universalgeek56/UG56-Lab-PSU/images/3D_PCB1_2026-02-25.png

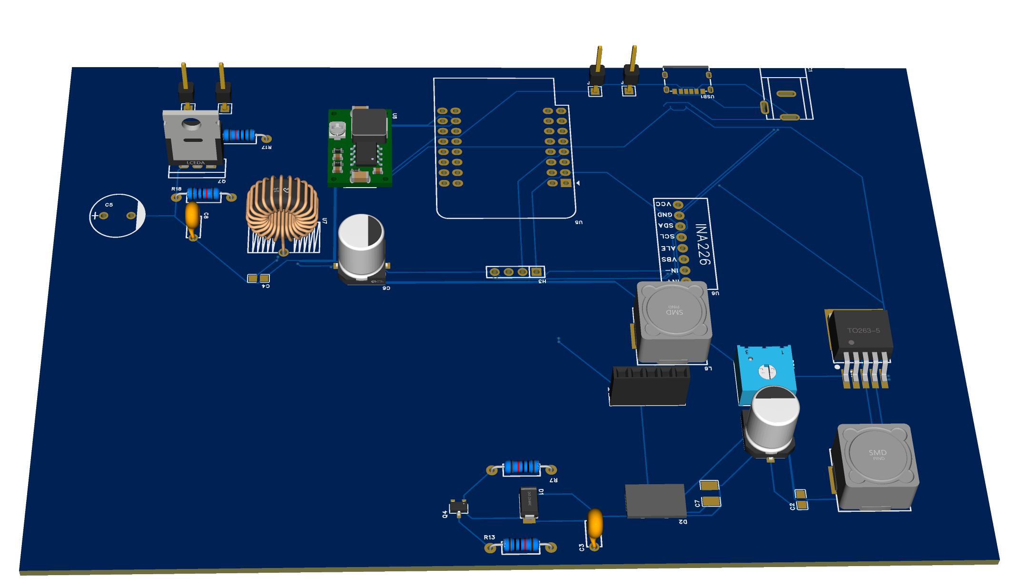
images/3D_PCB1_2026-02-25.png
