universalgeek56/UG56-Lab-PSU/images/AO3400_SMDtoDIP.JPG

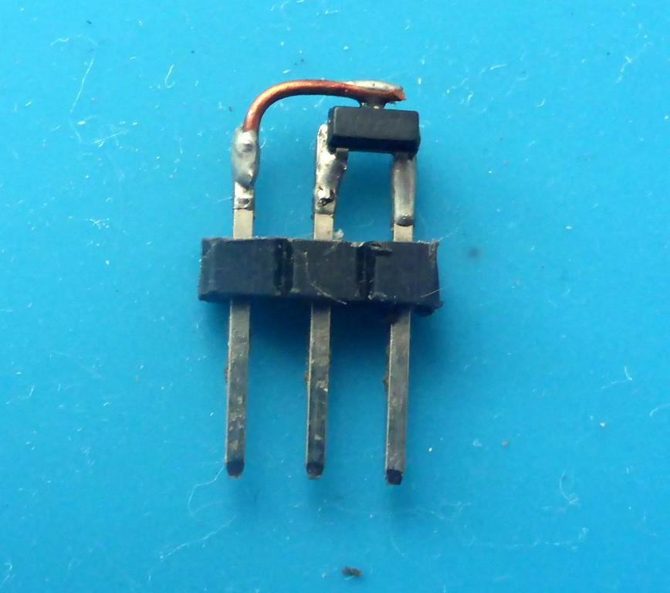
images/AO3400_SMDtoDIP.JPG
