universalgeek56/UG56-Lab-PSU/images/Case_Proto_V1_0.JPG

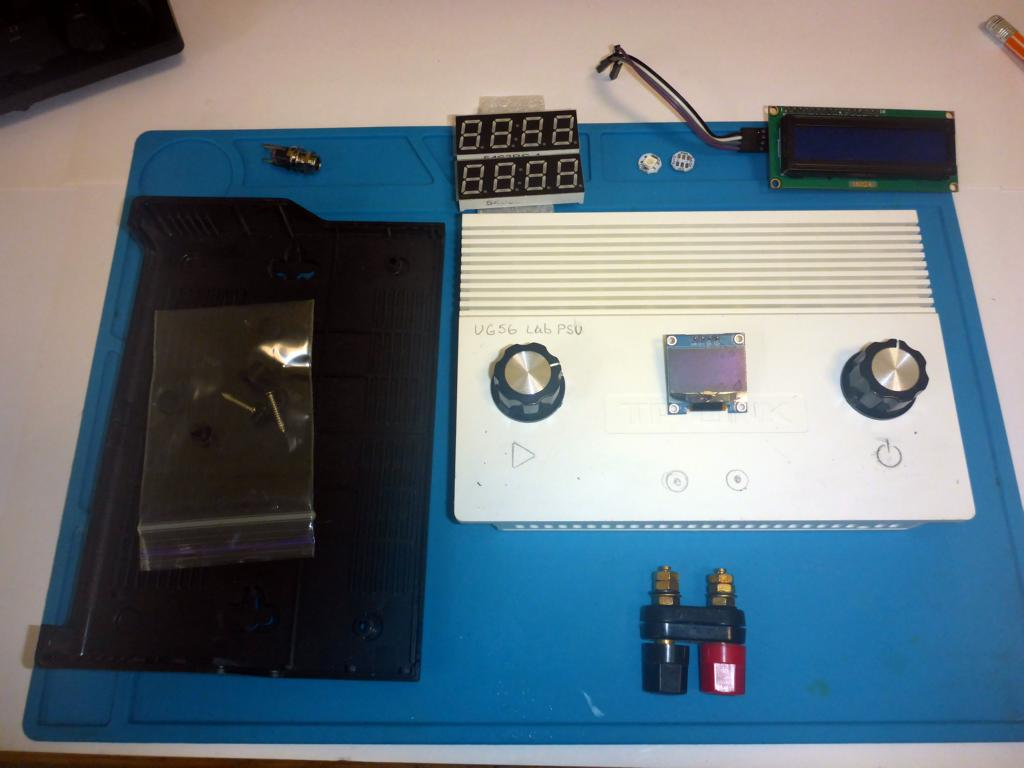
images/Case_Proto_V1_0.JPG
