universalgeek56/UG56-Lab-PSU/images/CaseV2_0.JPG

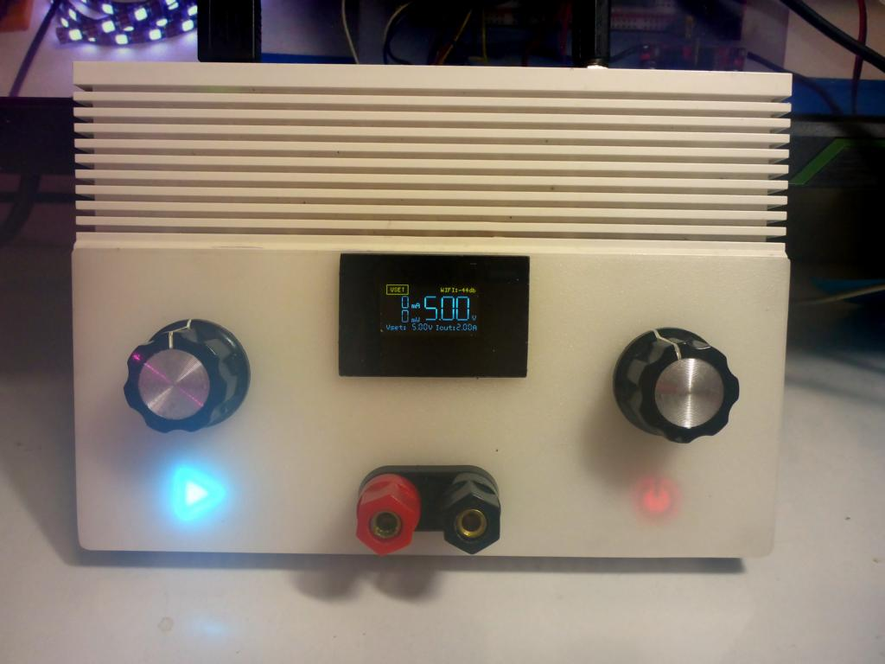
images/CaseV2_0.JPG
