universalgeek56/UG56-Lab-PSU/images/ESP32S2mini.png

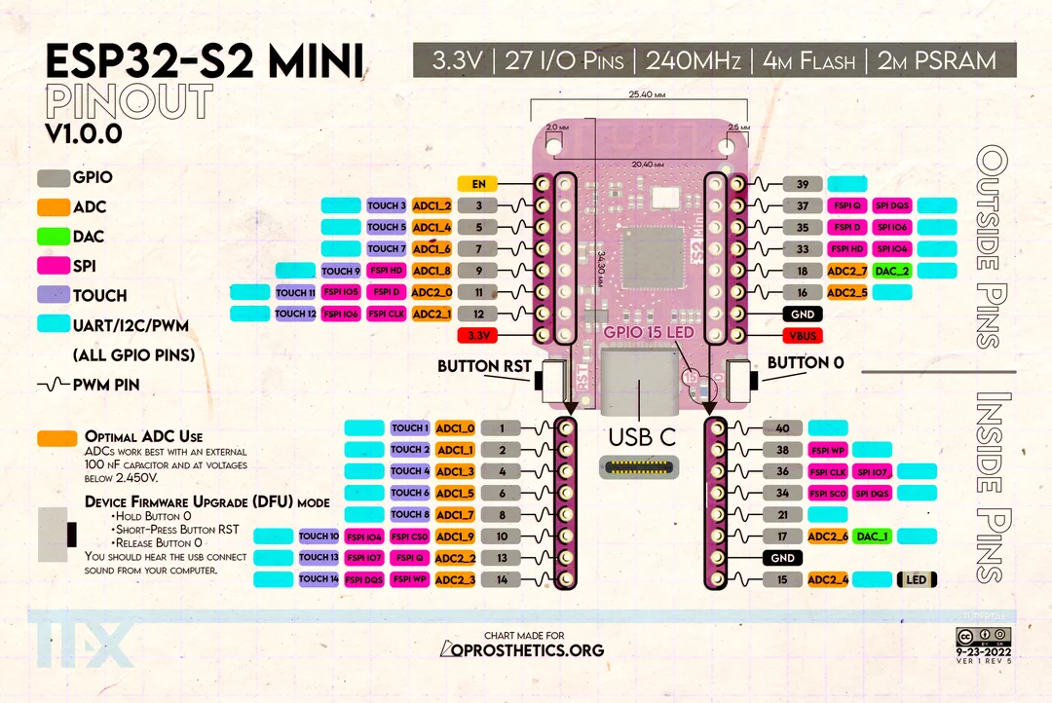
images/ESP32S2mini.png
