universalgeek56/UG56-Lab-PSU/images/PVC_iron_vs_SMD_lifehack.JPG

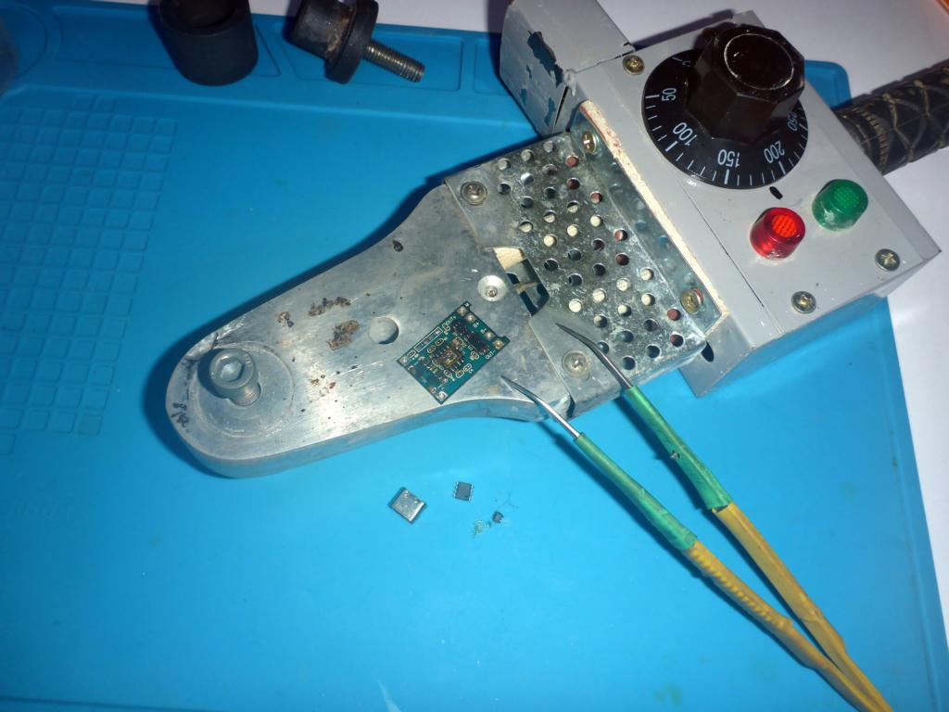
images/PVC_iron_vs_SMD_lifehack.JPG
