universalgeek56/UG56-Lab-PSU/images/Touch_UI.JPG

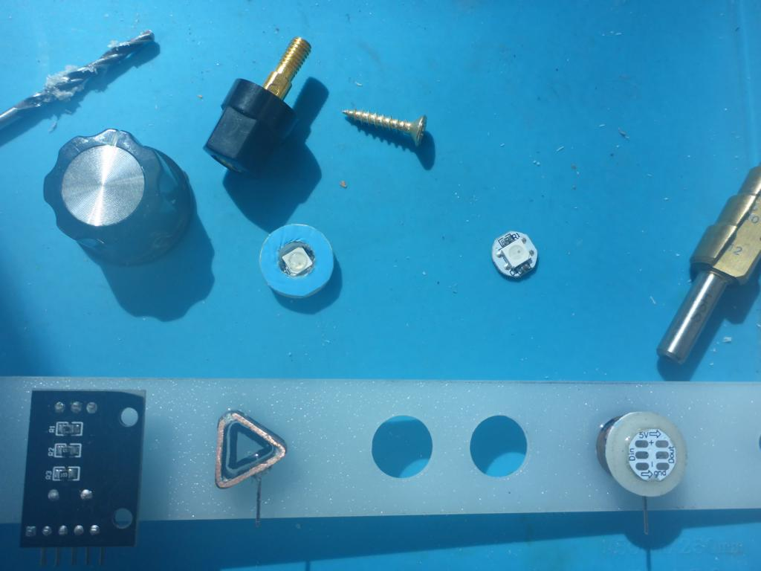
images/Touch_UI.JPG
