universalgeek56/UG56-Lab-PSU/images/Touch_UI_2.JPG

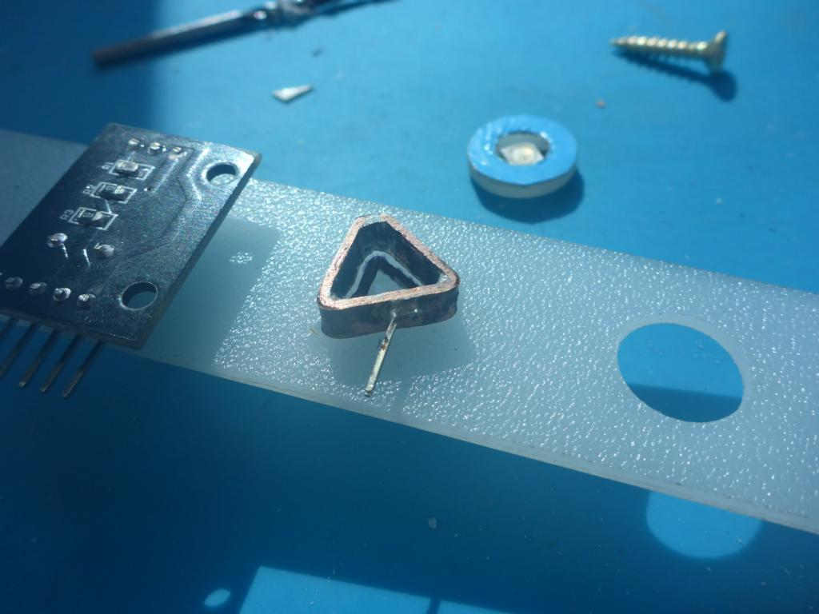
images/Touch_UI_2.JPG
