universalgeek56/UG56-Lab-PSU/images/V2_0.JPG

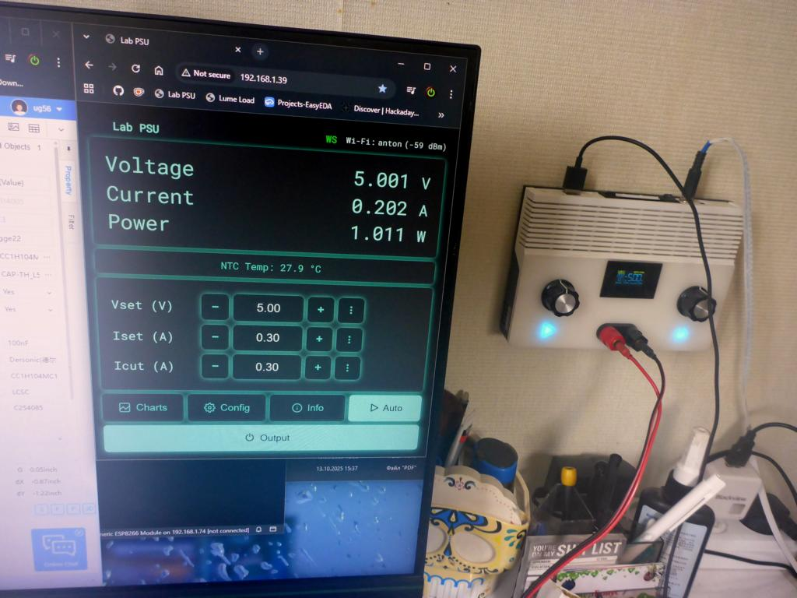
images/V2_0.JPG
