universalgeek56/UG56-Lab-PSU/images/Victims_of_Project.JPG

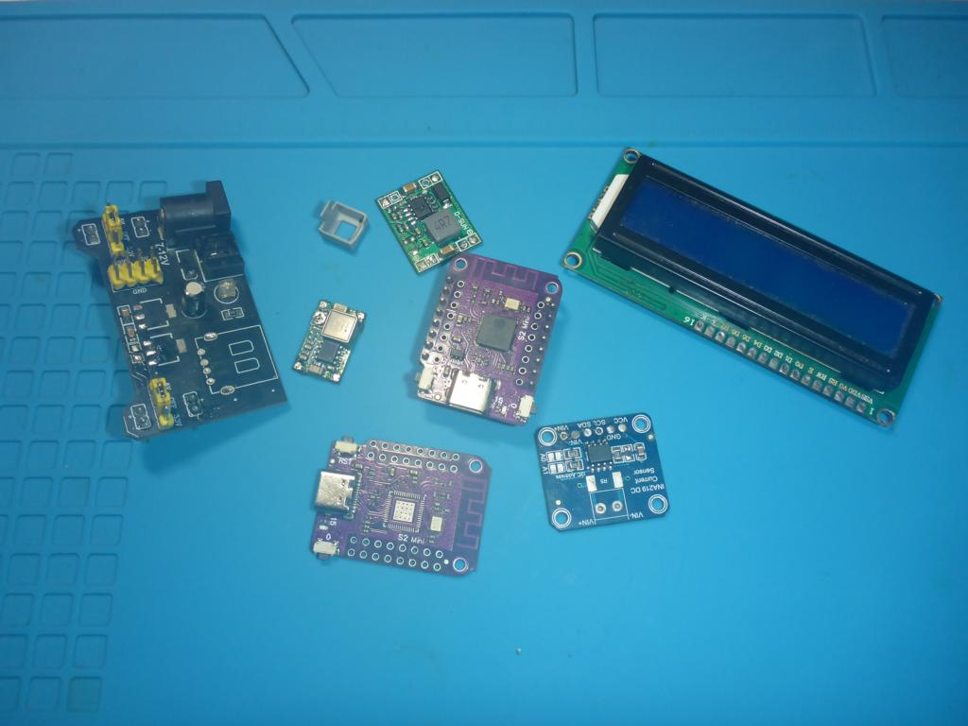
images/Victims_of_Project.JPG
